gbalke/ovc/hardware/ovc5/carrier/usb.kicad_sch

## KiCad design hardware/ovc5/carrier/usb.kicad_sch (2021-03-26)

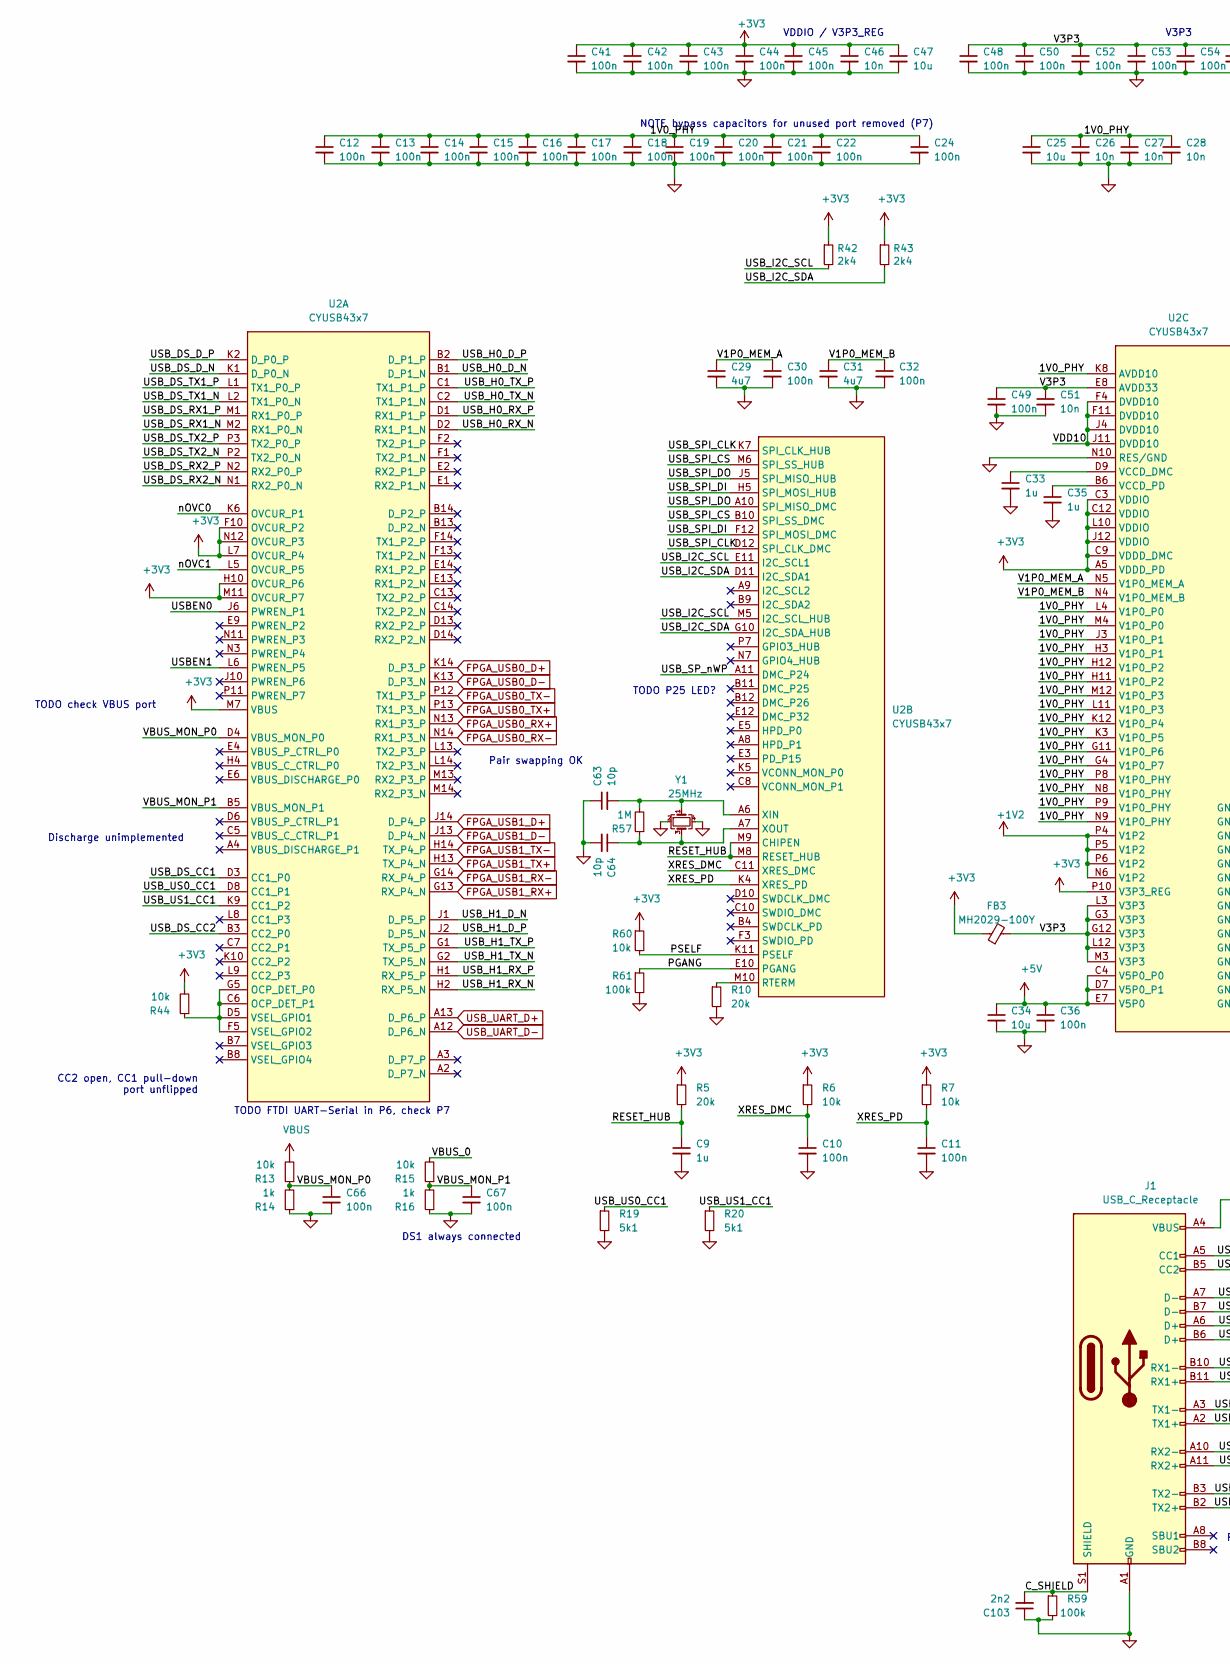
[picture p2: schematic usb.kicad_sch, part in row 1, column 1]

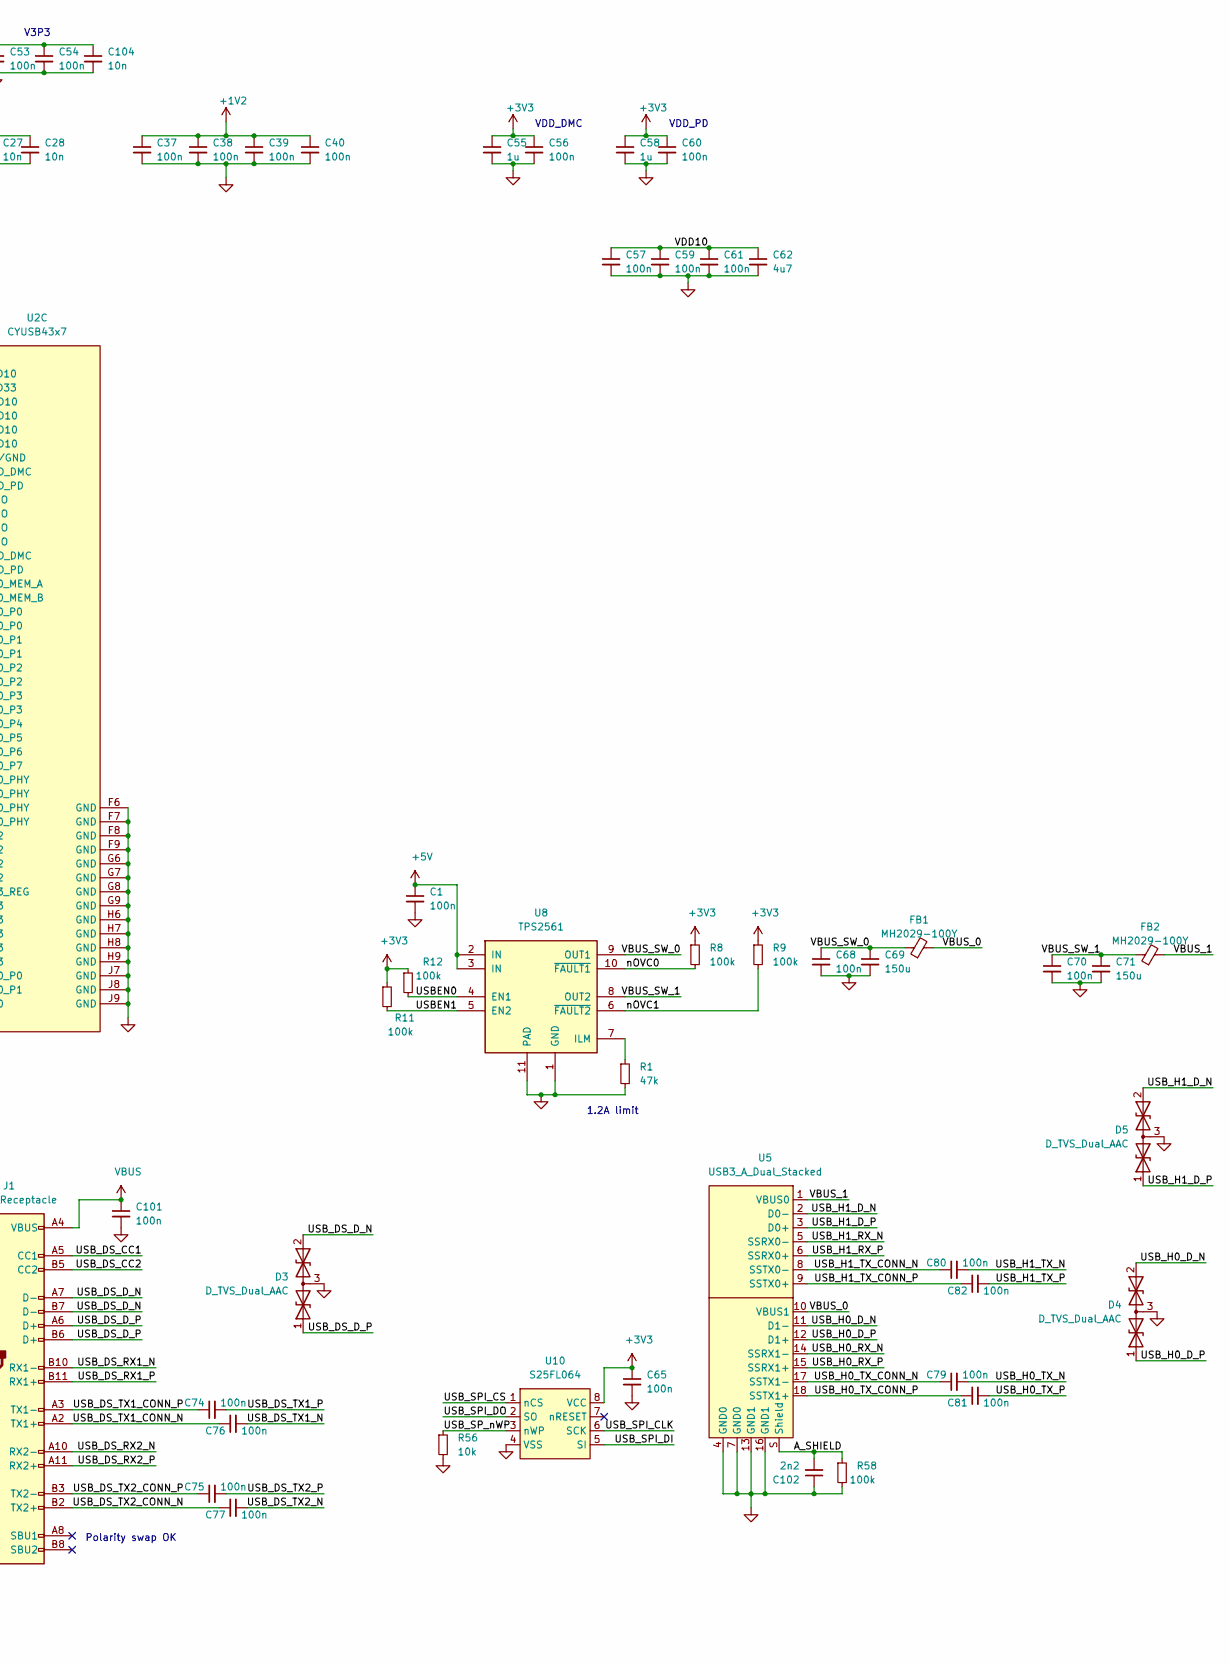
[picture p3: schematic usb.kicad_sch, part in row 1, column 2]

Parts:
C1, C10, C11, C12, C13, C14, C15, C16, C17, C18, C19, C20, C21, C22, C24, C30, C32, C36, C37, C38, C39, C40, C41, C42, C43, C44, C45, C48, C49, C50, C52, C53, C54, C56, C57, C59, C60, C61, C65, C66, C67, C68, C70, C74, C75, C76, C77, C79, C80, C81, C82, C101: 100n; C_0402_1005Metric; MPN CL05A104KA5NNNC
C9, C33, C35, C55, C58: 1u; C_0402_1005Metric; MPN CL05A105KP5NNNC
C25, C34, C47: 10u; C_0402_1005Metric; MPN CL05A106MP8NUB8
C26, C27, C28, C46, C51, C104: 10n; C_0402_1005Metric; MPN CL05B103KO5NNNC
C29, C31, C62: 4u7; C_0402_1005Metric; MPN LMK105BBJ475MVLF
C63, C64: 10p; C_0402_1005Metric; MPN UMK105CG100DV-F
C69, C71: 150u; C_Elec_6.3x7.7; MPN EEE-FKC151XAP
C102, C103: 2n2; C_0402_1005Metric; MPN CL05B222JB5NNNC
D3, D4, D5: D_TVS_Dual_AAC; TPD2EUSB30x; MPN TPD2EUSB30DRTR
FB1, FB2, FB3: MH2029-100Y; L_0805_2012Metric; MPN MH2029-100Y
J1: USB_C_Receptacle; USB_C_Receptacle_Wurth_632723300011; MPN 632723300011
R1: 47k; R_0402_1005Metric; MPN RC0402FR-0747KL
R5, R10: 20k; R_0402_1005Metric; MPN RC0402FR-0720KL
R6, R7, R13, R15, R44, R56, R60: 10k; R_0402_1005Metric; MPN AC0402FR-0710KL
R8, R9, R11, R12, R58, R59, R61: 100k; R_0402_1005Metric; MPN YAG3515CT-ND
R14, R16: 1k; R_0402_1005Metric; MPN RR0510P-102-D
R19, R20: 5k1; R_0402_1005Metric; MPN RR0510P-512-D
R42, R43: 2k4; R_0402_1005Metric; MPN ERA-2AED242X
R57: 1M; R_0402_1005Metric; MPN ERJ-2RKF1004X
U2: CYUSB43x7; BGA-192_14x14_12.0x12.0mm; MPN CYUSB4347-BZXCES
U5: USB3_A_Dual_Stacked; MPN 0484060003
U8: TPS2561; VSON-10-1EP_3x3mm_P0.5mm_EP1.65x2.4mm_ThermalVias; MPN TPS2561DRCR
U10: S25FL064; WSON-8-1EP_6x5mm_P1.27mm_EP3.4x4mm; MPN S25FL064LABNFI013
Y1: 25MHz; Crystal_SMD_2016-4Pin_2.0x1.6mm; MPN ABM11W-25.0000MHZ-7-K1Z-T3

Connections:
1V0_PHY: C12.1, C13.1, C14.1, C15.1, C16.1, C17.1, C18.1, C19.1, C20.1, C21.1, C22.1, C24.1, C25.1, C26.1, C27.1, C28.1, U2.G4 (V1P0_P7), U2.G11 (V1P0_P6), U2.H3 (V1P0_P1), U2.H11 (V1P0_P2), U2.H12 (V1P0_P2), U2.J3 (V1P0_P1), U2.K3 (V1P0_P5), U2.K8 (AVDD10), U2.K12 (V1P0_P4), U2.L4 (V1P0_P0), U2.L11 (V1P0_P3), U2.M4 (V1P0_P0), U2.M12 (V1P0_P3), U2.N8 (V1P0_PHY), U2.N9 (V1P0_PHY), U2.P8 (V1P0_PHY), U2.P9 (V1P0_PHY)
+1V2: C37.1, C38.1, C39.1, C40.1, U2.N6 (V1P2), U2.P4 (V1P2), U2.P5 (V1P2), U2.P6 (V1P2)
+3V3: C41.1, C42.1, C43.1, C44.1, C45.1, C46.1, C47.1, C55.1, C56.1, C58.1, C60.1, C65.1, FB3.1, R5.1, R6.1, R7.1, R8.1, R9.1, R11.1, R12.1, R42.1, R43.1, R44.2, R60.1, U2.A5 (VDDD_PD), U2.C3 (VDDIO), U2.C9 (VDDD_DMC), U2.C12 (VDDIO), U2.F10 (OVCUR_P2), U2.H10 (OVCUR_P6), U2.J12 (VDDIO), U2.L7 (OVCUR_P4), U2.L10 (VDDIO), U2.M7 (VBUS), U2.M11 (OVCUR_P7), U2.N12 (OVCUR_P3), U2.P10 (V3P3_REG), U10.8 (VCC)
+5V: C1.1, C34.1, C36.1, U2.C4 (V5P0_P0), U2.D7 (V5P0_P1), U2.E7 (V5P0), U8.2 (IN), U8.3 (IN)
A_SHIELD: C102.2, R58.1, U5.S (Shield)
C_SHIELD: C103.2, J1.S1 (SHIELD), R59.1
FPGA_USB0_D+: U2.K14 (D_P3_P)
FPGA_USB0_D-: U2.K13 (D_P3_N)
FPGA_USB0_RX+: U2.N13 (RX1_P3_P)
FPGA_USB0_RX-: U2.N14 (RX1_P3_N)
FPGA_USB0_TX+: U2.P13 (TX1_P3_N)
FPGA_USB0_TX-: U2.P12 (TX1_P3_P)
FPGA_USB1_D+: U2.J14 (D_P4_P)
FPGA_USB1_D-: U2.J13 (D_P4_N)
FPGA_USB1_RX+: U2.G13 (RX_P4_N)
FPGA_USB1_RX-: U2.G14 (RX_P4_P)
FPGA_USB1_TX+: U2.H13 (TX_P4_N)
FPGA_USB1_TX-: U2.H14 (TX_P4_P)
GND: C1.2, C9.2, C10.2, C11.2, C12.2, C13.2, C14.2, C15.2, C16.2, C17.2, C18.2, C19.2, C20.2, C21.2, C22.2, C24.2, C25.2, C26.2, C27.2, C28.2, C29.2, C30.2, C31.2, C32.2, C33.2, C34.2, C35.2, C36.2, C37.2, C38.2, C39.2, C40.2, C41.2, C42.2, C43.2, C44.2, C45.2, C46.2, C47.2, C48.2, C49.2, C50.2, C51.2, C52.2, C53.2, C54.2, C55.2, C56.2, C57.2, C58.2, C59.2, C60.2, C61.2, C62.2, C63.1, C64.2, C65.2, C66.2, C67.2, C68.2, C69.2, C70.2, C71.2, C101.2, C102.1, C103.1, C104.2, D3.3 (common), D4.3 (common), D5.3 (common), J1.A1 (GND), J1.A12 (GND), J1.B1 (GND), J1.B12 (GND), R1.2, R10.2, R14.1, R16.1, R19.2, R20.2, R56.2, R58.2, R59.2, R61.2, U2.F6 (GND), U2.F7 (GND), U2.F8 (GND), U2.F9 (GND), U2.G6 (GND), U2.G7 (GND), U2.G8 (GND), U2.G9 (GND), U2.H6 (GND), U2.H7 (GND), U2.H8 (GND), U2.H9 (GND), U2.J7 (GND), U2.J8 (GND), U2.J9 (GND), U2.N10 (RES/GND), U5.4 (GND0), U5.7 (GND0), U5.13 (GND1), U5.16 (GND1), U8.1 (GND), U8.11 (PAD), U10.4 (VSS), Y1.2, Y1.4
unnamed: C33.1, U2.D9 (VCCD_DMC)
unnamed: C35.1, U2.B6 (VCCD_PD)
unnamed: C63.2, R57.2, U2.A6 (XIN), Y1.1
unnamed: C64.1, R57.1, U2.A7 (XOUT), Y1.3
unnamed: R1.1, U8.7 (ILM)
unnamed: R10.1, U2.M10 (RTERM)
unnamed: R44.1, U2.C6 (OCP_DET_P1), U2.D5 (VSEL_GPIO1), U2.F5 (VSEL_GPIO2), U2.G5 (OCP_DET_P0)
PGANG: R61.1, U2.E10 (PGANG)
PSELF: R60.2, U2.K11 (PSELF)
RESET_HUB: C9.1, R5.2, U2.M8 (RESET_HUB), U2.M9 (CHIPEN)
USBEN0: R12.2, U2.J6 (PWREN_P1), U8.4 (EN1)
USBEN1: R11.2, U2.L6 (PWREN_P5), U8.5 (EN2)
USB_DS_CC1: J1.A5 (CC1), U2.D3 (CC1_P0)
USB_DS_CC2: J1.B5 (CC2), U2.B3 (CC2_P0)
USB_DS_D_N: D3.2 (A2), J1.A7 (D-), J1.B7 (D-), U2.K1 (D_P0_N)
USB_DS_D_P: D3.1 (A1), J1.A6 (D+), J1.B6 (D+), U2.K2 (D_P0_P)
USB_DS_RX1_N: J1.B10 (RX1-), U2.M2 (RX1_P0_N)
USB_DS_RX1_P: J1.B11 (RX1+), U2.M1 (RX1_P0_P)
USB_DS_RX2_N: J1.A10 (RX2-), U2.N1 (RX2_P0_N)
USB_DS_RX2_P: J1.A11 (RX2+), U2.N2 (RX2_P0_P)
USB_DS_TX1_CONN_N: C76.1, J1.A2 (TX1+)
USB_DS_TX1_CONN_P: C74.1, J1.A3 (TX1-)
USB_DS_TX1_N: C76.2, U2.L2 (TX1_P0_N)
USB_DS_TX1_P: C74.2, U2.L1 (TX1_P0_P)
USB_DS_TX2_CONN_N: C77.1, J1.B2 (TX2+)
USB_DS_TX2_CONN_P: C75.1, J1.B3 (TX2-)
USB_DS_TX2_N: C77.2, U2.P2 (TX2_P0_N)
USB_DS_TX2_P: C75.2, U2.P3 (TX2_P0_P)
USB_H0_D_N: D4.2 (A2), U2.B1 (D_P1_N), U5.11 (D1-)
USB_H0_D_P: D4.1 (A1), U2.B2 (D_P1_P), U5.12 (D1+)
USB_H0_RX_N: U2.D2 (RX1_P1_N), U5.14 (SSRX1-)
USB_H0_RX_P: U2.D1 (RX1_P1_P), U5.15 (SSRX1+)
USB_H0_TX_CONN_N: C79.1, U5.17 (SSTX1-)
USB_H0_TX_CONN_P: C81.1, U5.18 (SSTX1+)
USB_H0_TX_N: C79.2, U2.C2 (TX1_P1_N)
USB_H0_TX_P: C81.2, U2.C1 (TX1_P1_P)
USB_H1_D_N: D5.2 (A2), U2.J1 (D_P5_P), U5.2 (D0-)
USB_H1_D_P: D5.1 (A1), U2.J2 (D_P5_N), U5.3 (D0+)
USB_H1_RX_N: U2.H2 (RX_P5_N), U5.5 (SSRX0-)
USB_H1_RX_P: U2.H1 (RX_P5_P), U5.6 (SSRX0+)
USB_H1_TX_CONN_N: C80.1, U5.8 (SSTX0-)
USB_H1_TX_CONN_P: C82.1, U5.9 (SSTX0+)
USB_H1_TX_N: C80.2, U2.G2 (TX_P5_N)
USB_H1_TX_P: C82.2, U2.G1 (TX_P5_P)
USB_I2C_SCL: R42.2, U2.E11 (I2C_SCL1), U2.M5 (I2C_SCL_HUB)
USB_I2C_SDA: R43.2, U2.D11 (I2C_SDA1), U2.G10 (I2C_SDA_HUB)
USB_SPI_CLK: U2.D12 (SPI_CLK_DMC), U2.K7 (SPI_CLK_HUB), U10.6 (SCK)
USB_SPI_CS: U2.B10 (SPI_SS_DMC), U2.M6 (SPI_SS_HUB), U10.1 (nCS)
USB_SPI_DI: U2.F12 (SPI_MOSI_DMC), U2.H5 (SPI_MOSI_HUB), U10.5 (SI)
USB_SPI_DO: U2.A10 (SPI_MISO_DMC), U2.J5 (SPI_MISO_HUB), U10.2 (SO)
USB_SP_nWP: R56.1, U2.A11 (DMC_P24), U10.3 (nWP)
USB_UART_D+: U2.A13 (D_P6_P)
USB_UART_D-: U2.A12 (D_P6_N)
USB_US0_CC1: R19.1, U2.D8 (CC1_P1)
USB_US1_CC1: R20.1, U2.K9 (CC1_P2)
V1P0_MEM_A: C29.1, C30.1, U2.N5 (V1P0_MEM_A)
V1P0_MEM_B: C31.1, C32.1, U2.N4 (V1P0_MEM_B)
V3P3: C48.1, C49.1, C50.1, C51.1, C52.1, C53.1, C54.1, C104.1, FB3.2, U2.E8 (AVDD33), U2.G3 (V3P3), U2.G12 (V3P3), U2.L3 (V3P3), U2.L12 (V3P3), U2.M3 (V3P3)
VBUS: C101.1, J1.A4 (VBUS), J1.A9 (VBUS), J1.B4 (VBUS), J1.B9 (VBUS), R13.2
VBUS_0: FB1.2, R15.2, U5.10 (VBUS1)
VBUS_1: FB2.2, U5.1 (VBUS0)
VBUS_MON_P0: C66.1, R13.1, R14.2, U2.D4 (VBUS_MON_P0)
VBUS_MON_P1: C67.1, R15.1, R16.2, U2.B5 (VBUS_MON_P1)
VBUS_SW_0: C68.1, C69.1, FB1.1, U8.9 (OUT1)
VBUS_SW_1: C70.1, C71.1, FB2.1, U8.8 (OUT2)
VDD10: C57.1, C59.1, C61.1, C62.1, U2.F4 (DVDD10), U2.F11 (DVDD10), U2.J4 (DVDD10), U2.J11 (DVDD10)
XRES_DMC: C10.1, R6.2, U2.C11 (XRES_DMC)
XRES_PD: C11.1, R7.2, U2.K4 (XRES_PD)
nOVC0: R8.2, U2.K6 (OVCUR_P1), U8.10 (~FAULT1)
nOVC1: R9.2, U2.L5 (OVCUR_P5), U8.6 (~FAULT2)

Notes on the sheet:
TODO check VBUS port
Discharge unimplemented
CC2 open, CC1 pull-down port unflipped
DS1 always connected
TODO FTDI UART-Serial in P6, check P7
Pair swapping OK
NOTE bypass capacitors for unused port removed (P7)
TODO P25 LED?
VDDIO / V3P3_REG
V3P3
Polarity swap OK
VDD_DMC
1.2A limit
VDD_PD
