gbalke/ovc/(commit log)

2021-03-19 Reset cameras on boot to recover from bad state.
    [sensor_manager.cpp, sensor_manager.hpp]
2021-03-26 Redo layout of BGA WIP
    [ovc5.kicad_sch, usb.kicad_sch]
2021-07-01 Configs are divided by camera
2021-07-01 Add the ability to run device driver from makefile
2021-10-11 Simply generate an imshow for each camera's output
